zoemaestra/hair-electrolysis-machine-usb-c/3dprint/body_main.stl

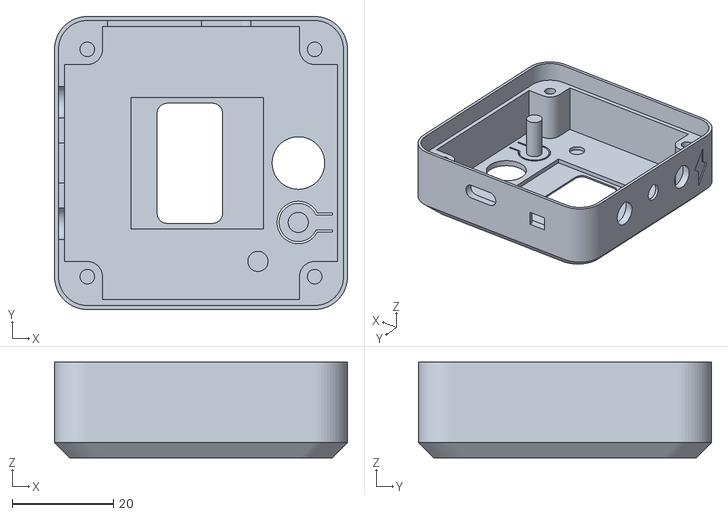
[picture p1: CAD file, 2026-10-17]
3dprint/body_main.stl
58.0 x 58.0 x 18.9
