zoemaestra/hair-electrolysis-machine-usb-c/hair-electrolysis-machine.kicad_pcb

## KiCad design hair-electrolysis-machine.kicad_pcb (2026-10-27)

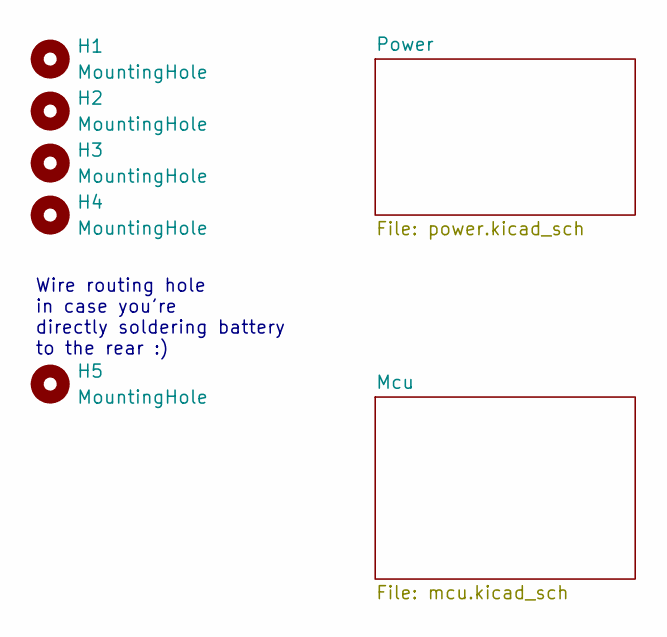
[picture p2: schematic hair-electrolysis-machine.kicad_sch]

Parts:
H1, H2, H3, H4: MountingHole; MountingHole_3.2mm_M3
H5: MountingHole; MountingHole_2.5mm

Notes on the sheet:
Wire routing hole in case you're directly soldering battery to the rear :)

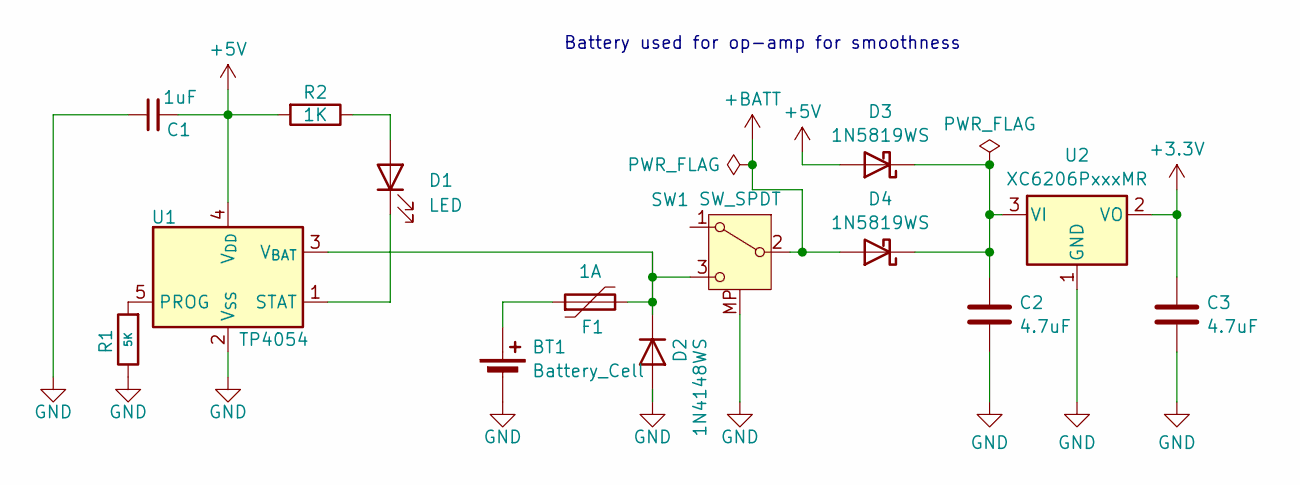
[picture p3: schematic power.kicad_sch]

Parts:
BT1: Battery_Cell; JST_PH_S2B-PH-K_1x02_P2.00mm_Horizontal; LCSC C16965
C1: 1uF; C_0603_1608Metric; LCSC C15849
C2, C3: 4.7uF; C_0805_2012Metric; LCSC C1779
D1: LED; LED_0805_2012Metric; LCSC C84256
D2: 1N4148WS; D_SOD-323; LCSC C2128
D3, D4: 1N5819WS; D_SOD-323; LCSC C191023
F1: 1A; Fuse_0805_2012Metric; LCSC C269104
R1: 5K; R_0603_1608Metric; LCSC C862232
R2: 1K; R_0603_1608Metric; LCSC C21190
SW1: SW_SPDT; SW_Slide_SPDT_Angled_CK_OS102011MA1Q; LCSC C131374
U1: TP4054; SOT-23-5; LCSC C668215
U2: XC6206PxxxMR; SOT-23-3; LCSC C5446

Connections:
+3.3V: C3.1, U2.2 (VO); also elsewhere on the board
+5V: C1.2, D3.2 (A), R2.2, U1.4 (V_{DD}); also elsewhere on the board
+BATT: D4.2 (A), SW1.2 (B); also elsewhere on the board
GND: BT1.2 (-), C1.1, C2.2, C3.2, D2.2 (A), R1.1, SW1.MP, U1.2 (V_{SS}), U2.1 (GND); also elsewhere on the board
unnamed: BT1.1 (+), F1.1
unnamed: D1.2 (A), R2.1
unnamed: D1.1 (K), U1.1 (STAT)
unnamed: D2.1 (K), F1.2, SW1.3 (C), U1.3 (V_{BAT})
unnamed: C2.1, D3.1 (K), D4.1 (K), U2.3 (VI)
unnamed: R1.2, U1.5 (PROG)

Notes on the sheet:
Battery used for op-amp for smoothness

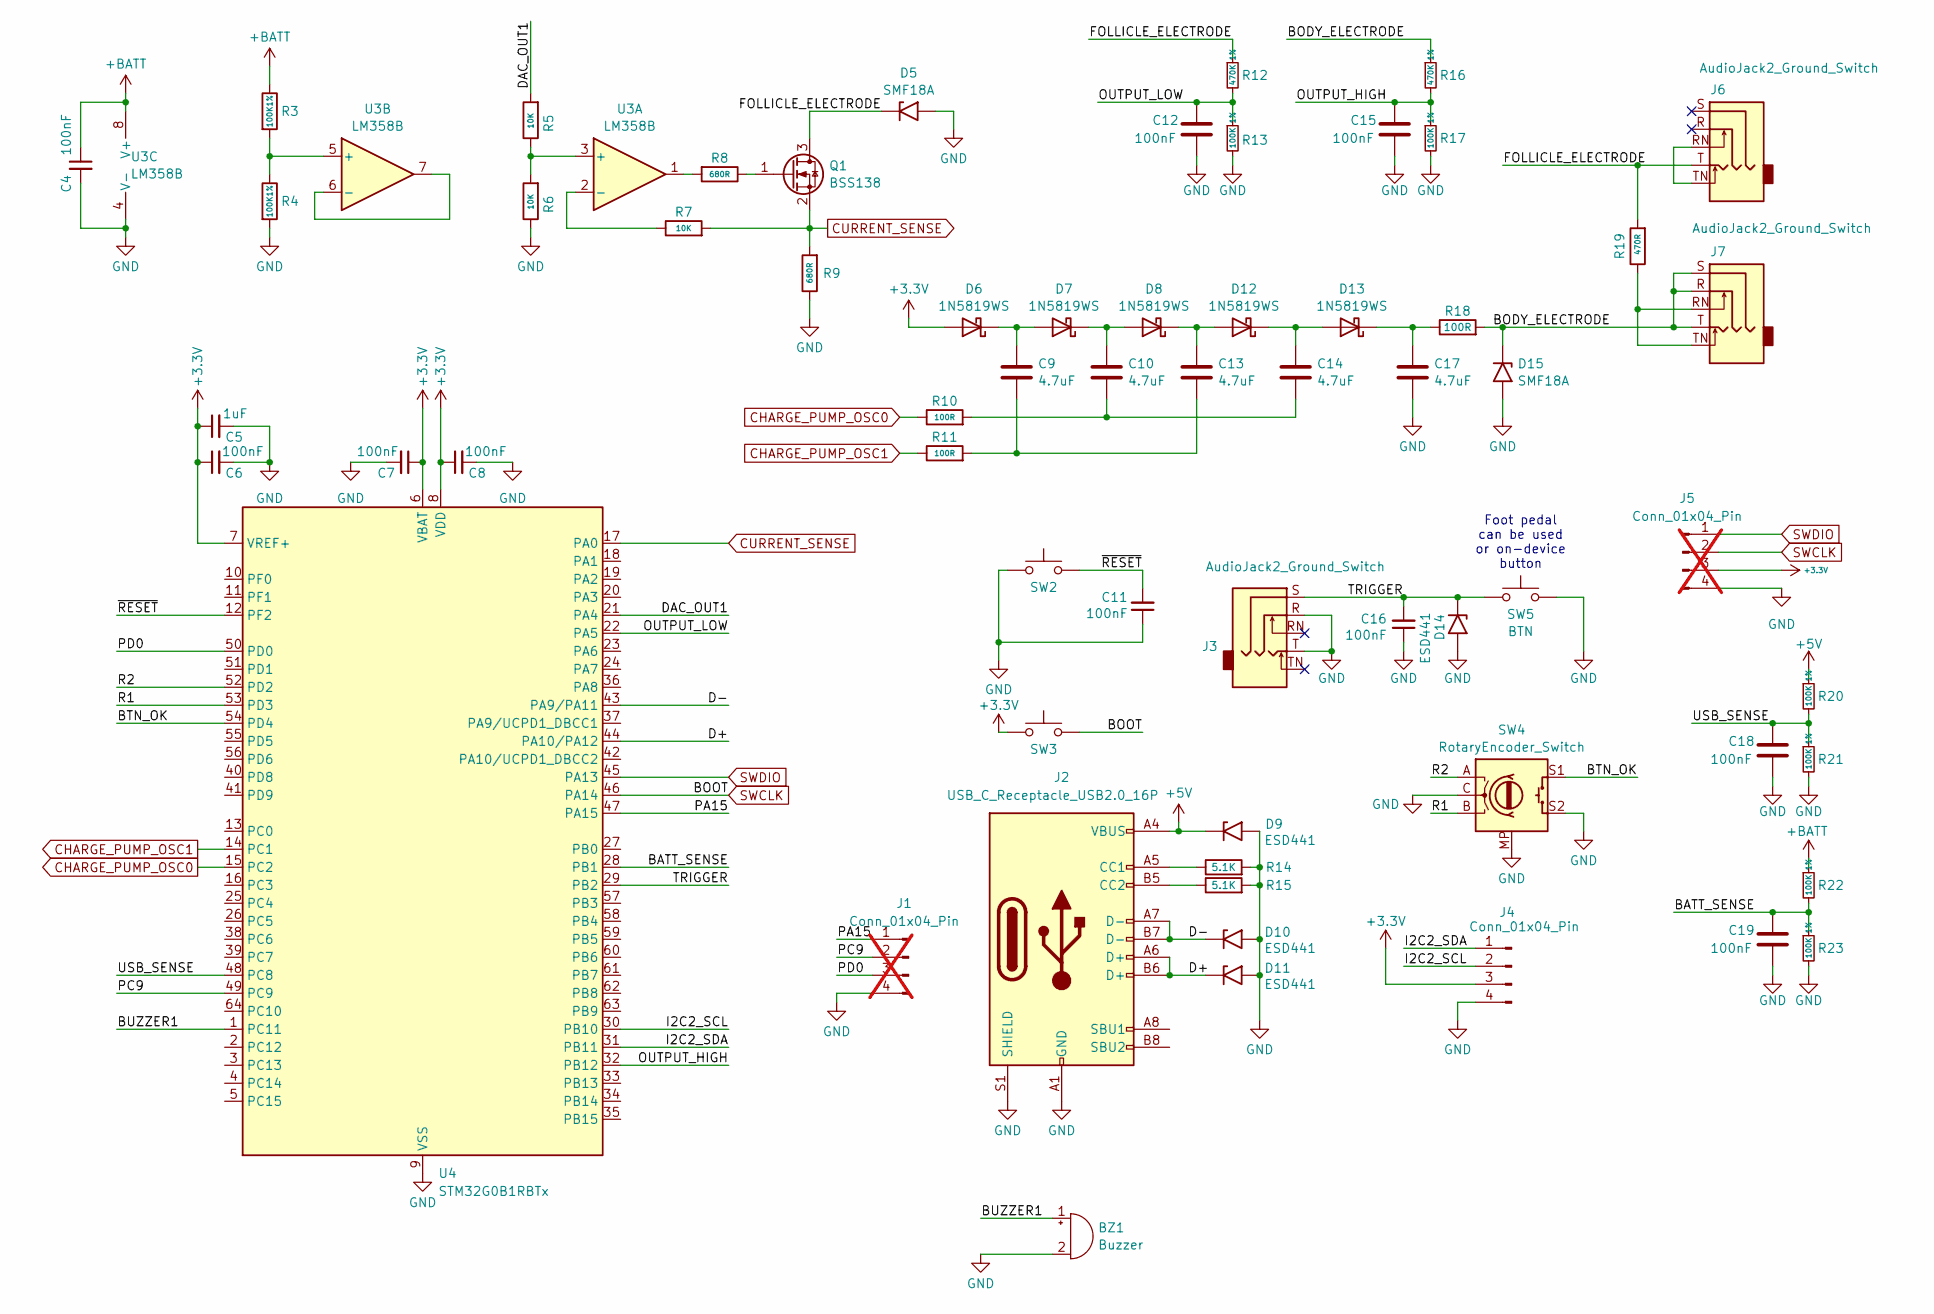
[picture p4: schematic mcu.kicad_sch]

Parts:
BZ1: Buzzer; Buzzer_TDK_PS1240P02BT_D12.2mm_H6.5mm; LCSC C76871
C4, C6, C7, C8, C11, C12, C15, C16, C18, C19: 100nF; C_0603_1608Metric; LCSC C14663
C5: 1uF; C_0603_1608Metric; LCSC C15849
C9, C10, C13, C14, C17: 4.7uF; C_0805_2012Metric; LCSC C1779
D5, D15: SMF18A; D_SMF; LCSC C169433
D6, D7, D8, D12, D13: 1N5819WS; D_SOD-323; LCSC C191023
D9, D10, D11, D14: ESD441; D_0402_1005Metric; LCSC C316049
J1: Conn_01x04_Pin; PinHeader_1x04_P2.54mm_Vertical; not fitted
J2: USB_C_Receptacle_USB2.0_16P; USB_C_Receptacle_HRO_TYPE-C-31-M-12; LCSC C165948
J3, J6: AudioJack2_Ground_Switch; Jack_3.5mm_CUI_SJ1-3525N_Horizontal; LCSC C16684
J4: Conn_01x04_Pin; PinSocket_1x04_P2.54mm_Vertical; LCSC C2718488
J5: Conn_01x04_Pin; PinSocket_1x04_P2.54mm_Vertical; not fitted
J7: AudioJack2_Ground_Switch; Jack_2.5mm_PJ242_6P_12x6.2x4mm_Horizontal; LCSC C431536
Q1: BSS138; SOT-23; LCSC C8490
R3, R4: 100K1%; R_0603_1608Metric_Pad0.98x0.95mm_HandSolder; LCSC C25803
R5, R6, R7: 10K; R_0603_1608Metric_Pad0.98x0.95mm_HandSolder; LCSC C25804
R8, R9: 680R; R_0603_1608Metric_Pad0.98x0.95mm_HandSolder; LCSC C23228
R10, R11, R18: 100R; R_0603_1608Metric; LCSC C22775
R12, R16: 470K 1%; R_0603_1608Metric; LCSC C23178
R13, R17, R20, R21, R22, R23: 100K 1%; R_0603_1608Metric; LCSC C25803
R14, R15: 5.1K; R_0603_1608Metric; LCSC C23186
R19: 470R; R_0603_1608Metric_Pad0.98x0.95mm_HandSolder; LCSC C23179
SW2, SW3, SW5: BTN; SW_SPST_TS-1088-xR025; LCSC C720477
SW4: RotaryEncoder_Switch; RotaryEncoder_Alps_EC11E-Switch_Vertical_H20mm; LCSC C2991196
U3: LM358B; SOIC-8_3.9x4.9mm_P1.27mm; LCSC C1850238
U4: STM32G0B1RBTx; LQFP-64_10x10mm_P0.5mm; LCSC C5143679

Connections:
+3.3V: C5.1, C6.1, C7.1, C8.1, D6.2 (A), J4.3, J5.3, SW3.2, U4.6 (VBAT), U4.7 (VREF+), U4.8 (VDD); also elsewhere on the board
+5V: D9.1 (A1), J2.A4 (VBUS), J2.A9 (VBUS), J2.B4 (VBUS), J2.B9 (VBUS), R20.1; also elsewhere on the board
+BATT: C4.1, R3.1, R22.1, U3.8 (V+); also elsewhere on the board
/Mcu/BATT_SENSE: C19.1, R22.2, R23.1, U4.28 (PB1)
/Mcu/BODY_ELECTRODE: D15.1 (A1), J7.R, J7.S, J7.T, R16.1, R18.2
/Mcu/BTN_OK: SW4.S1, U4.54 (PD4)
/Mcu/BUZZER1: BZ1.1 (+), U4.1 (PC11)
/Mcu/D+: D11.1 (A1), J2.A6 (D+), J2.B6 (D+), U4.44 (PA10/PA12)
/Mcu/D-: D10.1 (A1), J2.A7 (D-), J2.B7 (D-), U4.43 (PA9/PA11)
/Mcu/DAC_OUT1: R5.2, U4.21 (PA4)
/Mcu/FOLLICLE_ELECTRODE: D5.1 (A1), J6.T, Q1.3 (D), R12.1, R19.2
/Mcu/I2C2_SCL: J4.2, U4.30 (PB10)
/Mcu/I2C2_SDA: J4.1, U4.31 (PB11)
/Mcu/OUTPUT_HIGH: C15.1, R16.2, R17.1, U4.32 (PB12)
/Mcu/OUTPUT_LOW: C12.1, R12.2, R13.1, U4.22 (PA5)
/Mcu/PA15: J1.1, U4.47 (PA15)
/Mcu/PC9: J1.2, U4.49 (PC9)
/Mcu/PD0: J1.3, U4.50 (PD0)
/Mcu/R1: SW4.B, U4.53 (PD3)
/Mcu/R2: SW4.A, U4.52 (PD2)
/Mcu/TRIGGER: C16.2, D14.1 (A1), J3.S, SW5.2, U4.29 (PB2)
/Mcu/USB_SENSE: C18.1, R20.2, R21.1, U4.48 (PC8)
/Mcu/~RESET: C11.2, SW2.1, U4.12 (PF2)
CHARGE_PUMP_OSC0: R10.1, U4.15 (PC2)
CHARGE_PUMP_OSC1: R11.1, U4.14 (PC1)
CURRENT_SENSE: Q1.2 (S), R7.2, R9.2, U4.17 (PA0)
GND: BZ1.2 (-), C4.2, C5.2, C6.2, C7.2, C8.2, C11.1, C12.2, C15.2, C16.1, C17.2, C18.2, C19.2, D5.2 (A2), D9.2 (A2), D10.2 (A2), D11.2 (A2), D14.2 (A2), D15.2 (A2), J1.4, J2.A1 (GND), J2.A12 (GND), J2.B1 (GND), J2.B12 (GND), J2.S1 (SHIELD), J3.R, J3.T, J4.4, J5.4, R4.2, R6.1, R9.1, R13.2, R14.2, R15.2, R17.2, R21.2, R23.2, SW2.2, SW4.C, SW4.MP, SW4.S2, SW5.1, U3.4 (V-), U4.9 (VSS); also elsewhere on the board
unnamed: C10.2, C14.2, R10.2
unnamed: C9.2, C13.2, R11.2
unnamed: C9.1, D6.1 (K), D7.2 (A)
unnamed: C10.1, D7.1 (K), D8.2 (A)
unnamed: C13.1, D8.1 (K), D12.2 (A)
unnamed: C14.1, D12.1 (K), D13.2 (A)
unnamed: C17.1, D13.1 (K), R18.1
unnamed: J2.A5 (CC1), R14.1
unnamed: J2.B5 (CC2), R15.1
unnamed: J6.RN, J6.TN
unnamed: J7.RN, J7.TN, R19.1
unnamed: Q1.1 (G), R8.1
unnamed: R8.2, U3.1
unnamed: R5.1, R6.2, U3.3 (+)
unnamed: R7.1, U3.2 (-)
unnamed: R3.2, R4.1, U3.5 (+)
unnamed: U3.6 (-), U3.7
SWCLK: J5.2, SW3.1, U4.46 (PA14)
SWDIO: J5.1, U4.45 (PA13)

Notes on the sheet:
Foot pedal can be used or on-device button

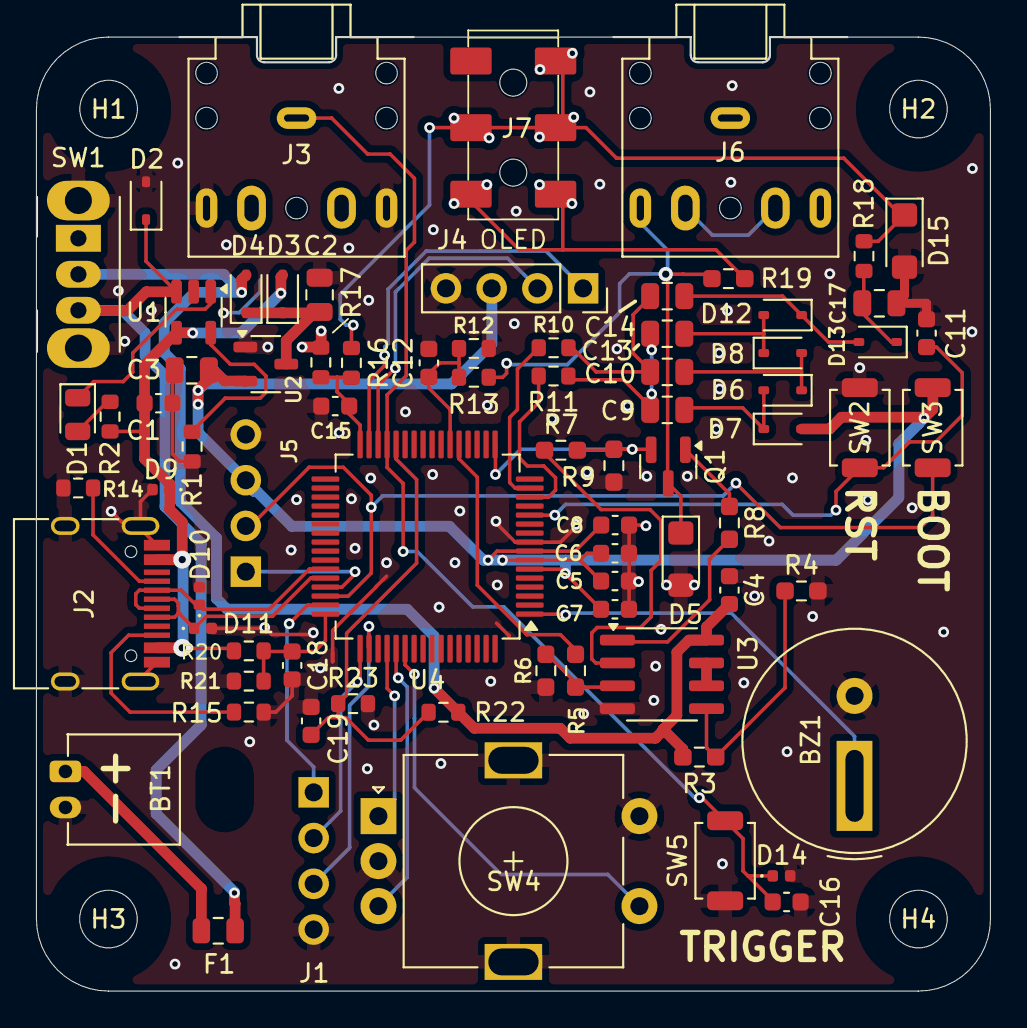
[picture p5: board hair-electrolysis-machine.kicad_pcb from above]

Board: 2 copper layers, 53.0 x 53.0 mm, 82 parts (0 on the bottom side), 52 nets.
