zoemaestra/hair-electrolysis-machine-usb-c/(commit log)

2026-05-05 Project details and BOM links
2026-05-10 Added .stl files
    [case.stl, pen-Body.stl, pen-Cap.stl]
2026-05-19 Improved case design & rotary encoder knob
    [case.stl, knob.stl]
2026-05-21 Minor modifications
    Knob allows for more travel for better clicks and switch hole is made larger so installation is easier
    [case.stl, knob.stl]
2026-05-21 Minor mounting alterations
    Mount holes are wide enough to take M3 screws through them
    [hair-electrolysis-machine.kicad_pcb]
2026-05-21 Add screws to the components list in README
    Added a note about screws to the components list.
2026-05-21 Add image
    Removed outdated comment about mini USB cables.
2026-05-29 Revise README with cost breakdown and assembly notes
    Updated cost breakdown and additional details about assembly and components.
2026-06-18 Minor changes
    Moved 5v line out from under USB-C connector and changed buzzer pads so more common buzzers can more easily be used
    [hair-electrolysis-machine.kicad_pcb]
2026-06-22 Added JLC BOM
    [bom.csv]
2026-06-22 Update README with BOM details and additional items
    Added information about BOM usage and additional components.
2026-06-22 Minor D9 ground changes
    [hair-electrolysis-machine.kicad_pcb]
2026-06-22 Uploading the right version this time...
    [hair-electrolysis-machine.kicad_pcb]
2026-07-25 Fix minor wording issue in README
    Removed an incomplete sentence fragment regarding the BOM.
2026-08-12 Beginning of redesign to use STM32G0B1RETx
    [hair-electrolysis-machine.kicad_sch]
2026-08-15 fixed some shorts and bad dummy load configuration
    [hair-electrolysis-machine.kicad_pcb, mcu.kicad_sch]
2026-08-15 tiny silkscreen edits
    [hair-electrolysis-machine.kicad_pcb]
2026-08-16 Fix C37 LCSC code, changed buttons to C720477
    [hair-electrolysis-machine.kicad_pcb, mcu.kicad_sch]
2026-08-16 Removed USB resistors, shuffled breakout pins to tidy up a tad
    [hair-electrolysis-machine.kicad_pcb, mcu.kicad_sch]
2026-08-16 Forgot to ground switch housing. This WILL happen again.
    [hair-electrolysis-machine.kicad_pcb]
2026-08-16 Silkscreen fixes
    [hair-electrolysis-machine.kicad_pcb, hair-electrolysis-machine.kicad_sch, power.kicad_sch]
2026-08-20 Use STM32G0B1RBTx, fix up some silkscreen, maybe production ready?
    [hair-electrolysis-machine.kicad_pcb, hair-electrolysis-machine.kicad_sch, mcu.kicad_sch]
2026-08-20 Added charge indicator LED, upped charge pump capacitor bank voltage rating for more headroom
    [hair-electrolysis-machine.kicad_pcb, mcu.kicad_sch, power.kicad_sch]
2026-08-20 Fixed switch mounting holes not being grounded
    [hair-electrolysis-machine.kicad_pcb, power.kicad_sch]
2026-08-23 Some minor clean ups
    [bom.csv, designators.csv, hair-electrolysis-machine.kicad_pcb, mcu.kicad_sch, positions.csv, power.kicad_sch]
2026-09-07 Silkscreen edits and moved F1 to more maintainable spot
    [hair-electrolysis-machine.kicad_pcb, output.kicad_sch]
2026-09-07 Added wire routing hole
    [hair-electrolysis-machine.kicad_pcb, hair-electrolysis-machine.kicad_sch]
2026-09-16 Make buzzer single sided for simplicity
    [hair-electrolysis-machine.kicad_pcb, mcu.kicad_sch]
2026-09-16 Revise README for Hair Electrolysis Machine v4
    Updated project title and clarified development status. Added cautionary note regarding building the device and recommended using the RP2040 version.
2026-10-04 change jack pinout and charge limiting
    limit charge speed to be more conservative and change jack pins used so there's zero overlap between pedal and stylus
2026-10-17 Design modification
    Modified design for lower tolerance printers
2026-10-27 Update README with assembly details for foot pedal and stylus
    Clarified assembly instructions regarding soldering for the stylus and foot pedal.
2026-10-27 v4.1, see commit for details
    Added passthrough hole for battery wires for users soldering batteries in
    Cleared ground plane under screw holes
    Uses only 3.5mm tip for stylus and sleeve for the pedal
    Better anchoring for the 2.5mm jack for improved durability
